despdx/ccdcamera-interface-card/README.md

CCD Camera Interface Card
======

Motivation
--------------
In order to run our CCD camera with our new Archon controller, in is necessary
to design and build an interface card/board to properly route electrical
connections from the Archon ERF8 connectors to the CCD personality card.  This
is the documentation for that card.

### Copyright 2016 Paul R. DeStefano
>   This program is free software: you can redistribute it and/or modify
>   it under the terms of the GNU General Public License as published by
>   the Free Software Foundation, either version 3 of the License, or
>   (at your option) any later version.

>   This program is distributed in the hope that it will be useful,
>   but WITHOUT ANY WARRANTY; without even the implied warranty of
>   MERCHANTABILITY or FITNESS FOR A PARTICULAR PURPOSE.  See the
>   GNU General Public License for more details.

>   You should have received a copy of the GNU General Public License
>   along with this program.  If not, see <http://www.gnu.org/licenses/>.
