despdx/ccdcamera-interface-card/(commit log)

2016-07-12 Initial Commit v4
    [try1.kicad_pcb, try1.sch]
2016-07-20 Version 7
    [try1.sch]
2016-07-20 Version 11
    Big jump. I got proper part libraries (.lib) for KiCad by using a ULP
    for Eagle to convert Eagle part libraries (.lbr) to KiCad format.
    [try1.sch]
2016-07-21 Add library: archon
    I created another project-specific library.
    [try1.sch]
2016-07-21 Rename connectors, conflicts
    [try1.sch]
2016-07-21 Version 12
    [try1.sch]
2016-07-21 Update archon library
    Add all other Archon connector mates/headers that I think we will need
    for this project.
2016-07-21 Remake schematic from project archon libarary
    I replaced all of the ERM8 symbols with the project's archon library
    that I just made.
    [try1.sch]
2016-07-22 Label dewar connections
    [try1.sch]
2016-07-22 Add true no-connect flag to Archon pins
    Some pins behind the Archon ERF8 connectors are, in fact, not connected
    to anything on their Archon modules. I marked these on the schematic.
    Maybe I should mark them on in the archon part library?
    [try1.sch]
2016-07-22 Fix no-connect for dewar connectors.
    Removed the unnecessary wires on non-connect pins from the dewar
    connectors.
    [try1.sch]
2016-07-22 Add additional connectors
    Added two RJ45 connectors for heater.
    Add DB9 for projector and LED control.
    [try1.sch]
2016-07-22 Switch out RJ45 connectors
    I think we cannot use the "magnetics" RJ45 since we need to pass DC
    signals. But, we do want to get shielded twisted-pair cables, so I
    modified an existing RJ45 symbol to have a shielding pin.
    [try1.sch]
2016-07-22 Change position of RJ45 connectors
    [try1.sch]
2016-07-22 Version 31
    [try1.sch]
2016-07-22 Change my name
    [try1.sch]
2016-07-29 Finish version 31
    [try1.sch]
2016-07-29 Incomplete Wireing (v39)
    Switched out RJ45 connectors for DVI.
    Partially completed connections.
    [try1.sch]
2016-08-03 Version 41: Partial Wiring
    Still very incomplete, but I finished the first pass on wiring. This
    version includes Morley's first pin assignments and some extra changes
    we talked about, today.
    [try1.sch]
2016-08-18 Add heater power connector
    Added Mini-FiT-Jr 5566 2x2 footprint and connector to hold heater power
    connections to cold finger heater and radiation shield heater.
    [try1.sch]
2016-08-18 Connect heater/DVI, label shutter connector
    [try1.sch]
2016-08-23 schematic: chg ResetHI_L/R to ~(not) logic
    [try1.sch]
2016-08-23 fill with non-connects
    Added non-connect flags for all unassinged pins.
    [try1.sch]
2016-08-23 Update comment for DVI connector re:shield pins
    [try1.sch]
2016-08-23 Label extra ADC MOD6 card for furture use.
    I intend to pull these out to spare pads.
    [try1.sch]
2016-08-23 Rename GND pin on Shutter Connector
    [try1.sch]
2016-08-23 Update Dewar PINs
    Changed GND to connector-specific names.
    Connect 5V,15V,&-15V to bias modules.
    Change GainSW2 name to connector-specific names.
    [try1.sch]
2016-08-24 Connect spare pins on dewar to pads
    [try1.sch]
2016-08-25 Connect signal ground, add LED select jumper
    Add hack to connect CCD signal ground to Driver module
    Add jumper component for selection of LED in dewar, no yet connected
    Added some text comments
    Reposition Heater module
    [try1.sch]
2016-08-25 Auto-Annotate
    Annotate parts added since the last time I did it.
    [try1.sch]
2016-08-25 Fix DVI spare pin label names
    [try1.sch]
2016-08-31 Swap ADC _P&_N channel connections to CCD OUTPUT
    Standard CCD measurements take 0V to be max DN. After consulting the
    Archon documentation, this is the assumption that is implied. So, I
    have changed it.
    [try1.sch]
2016-08-31 Change +-15V to LV low current biases
    I previously connected +-15 to HV biases, but we need high current, for
    one thing, and we also rather use LV, eventhought it only allows +-14V.
    [try1.sch]
2016-08-31 Reassign LV4 CH3&4 to GainSW2;CH4&5 to 5V
    I moved LV4 low current channels 3&4 to GainSW2 on the dewar connectors.
    5V only needs low current, so I assigned those to LV biases 5&6, which
    were freed in the previous commit. In doing this, I reordered 5 & 15V
    connetions on the dewar.
    [try1.sch]
2016-08-31 Remove jumpers for LED Select
    This isn't right. The LED Select pins are a 2bit digital value. We may
    run them with DIO or LV, depending on how the DIO can be managed.
    [try1.sch]
2016-08-31 Conn LED Select to LV; Add CCD OUT jumpers to GND
    For now, I have connected the LED Select signals to LV biases as I know
    how to operate them, already. If I can use DIO, I'll change it.
    Added jumpers to connect CCD OUT_X_GND to interface GND plane. We're
    not sure at this point if this will help or hurt noise performance.
    [try1.sch]
2016-08-31 Tie dewar GND to interface GND
    It's clear that all grounds in the dewar (on the personality card and
    the side cards) are all tied together. So, there isn't any point, as
    far as I know, to maintaining independent wiring on the interface card.
    This commit removes independent grounds for each side and relabels
    everything to the GND plane.
    [try1.sch]
2016-09-01 Fix Shutter Control DB9 Pin Assignments
    Oops, I did this wrong. The illuminator/LED control board has J73, but
    it is a single row 10pin. The DB-9 is un-named on the schematic, but is
    documented. Denis found it and this patch corrects the pinouts.
    [try1.sch]
2016-09-01 Fix Shutter DB9, again
    We traced it with DMM and now are certain.
    [try1.sch]
2016-09-02 Finish Shutter
    Place biases and drivers for shutter control connection. This includes
    drivers for the FLASH_V/STB lines as well as HV high current biases for
    the LED power lines.
    [try1.sch]
2016-09-02 Update Shutter Control
    Now I'm not so sure about the last commit. This patch actually
    completes the assignment of all shutter control pins. I'm not sure it's
    right, but it is complete, now.
    I also changed FLASH_STB to a HV high current bias, as I think it is
    actually the current source for the LEDs. 15V and 5V lines are still HV
    high current also, eventhough I think only two high current supplies are
    required for the shutter board. I asked Denis about it.
    [try1.sch]
2016-09-06 Change Sutter Connector Labels for LED Pins
    These "SHUT_" biases are really for the LEDs. So, we changed those label
    names to be more apropos.
    [try1.sch]
2016-09-06 Fix P1Y Label
    [try1.sch]
2016-09-06 Assign ResetLO to LV, not HV
    ResetLO needs to go negative, so we must assign it to the LV module, not
    the HV module.
    [try1.sch]
